Jojotheamazing/RcCar/README.md

# RcCar
Turning a simple hot wheel minicooper to functional. The plan is to get it to behave like a rc car controlled by my phone. This is my a testing project planning on going even smaller next time.
CAD files can be viewed on https://cad.onshape.com/documents/0ecd8efb05e9275814de94fb/w/fa9c31af8d81ab698a521477/e/6228325a7ca9a583648467fb its a public document onShape.
