Jojotheamazing/RcCar/Hot wheel-_rc car-bom.csv

Name | Purpose | Quantity | Total Cost (USD) | Link | Distributor
Esp32 mini c3 | Controlling with the phone | 1 | 2.40 | https://www.aliexpress.com/item/1005010312887045.html?curPageLogUid=ZZZyJdpMKHje | AliExpress
Motor driver | Control the motor | 1 | 1.60 | https://www.aliexpress.com/item/1005009044264044.html?mp=1 | AliExpress
