Jojotheamazing/RcCar/Assembly 2.step

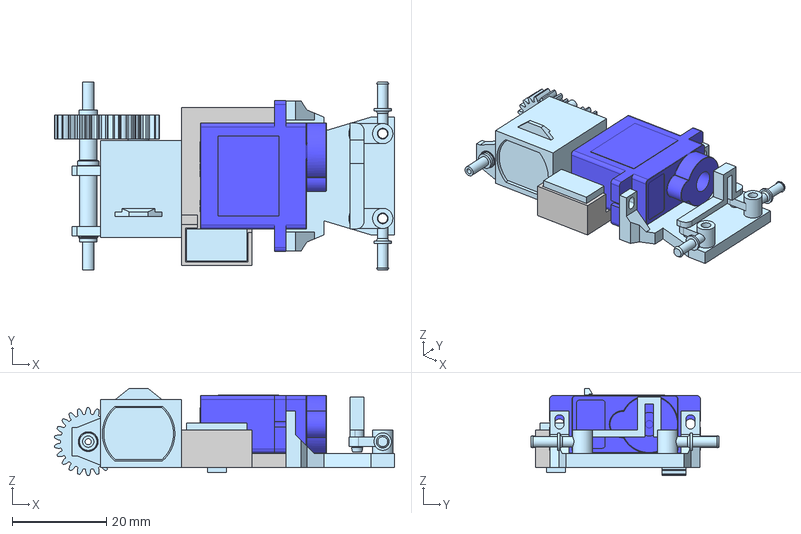
[picture p1: CAD file, 2026-03-25]
Assembly 2.step
72.2 x 40.0 x 18.5 mm
Spur gear (13 teeth)
Spur gear (22 teeth)
SG90 - Micro Servo 9g - Tower Pro.1_Pe�a
