Jojotheamazing/RcCar/JOURNAL.md

<!--
  This journal is auto generated by Stasis.
-->

# 4/3/2026 12 PM - The coding part.1

_Time spent: 1.333333333333333h_

Using websockets i made a code wich runs on the esp32 that creates a wifi network where phones and other devices can connect and controll the car. Its really nice since it doesnt require any app downloads and you dont need to carry a controller as well you just move it with and wifi capable device. i havent tested the range yet but in theory it should be decent. The website as i mentioned uses websokcets so it is real time which is needed it has basic ui that i proably change since i just wanted a test. It has a slider for throtle, steering and has settings for steeringOffset and max speed and also a beta feature for smooth accelaration and a save button which saves the values to the esp32 on board memory so you dont have to change it all the time(there is an issue that i havent worked on which when you load the website it doesnt show the setting but just the defaults however the settings are kept). 







# 4/2/2026 9 AM - Soldering & TPU tires

_Time spent: 2h_

Wanted to have a more complete version add be able to test it so i solder all the components together. After many attempts i finally figured it out since i had problems with the signal of the servo being inteferanced and making weird noise. I should add 2 capacitors as well but my soldering iron broke and i am currently wiating for them to replace it since its only 3 months old. I am facing some issues with the gear that i will work on (They sometimes get on a weird angle and jam it might be the way it is 3d printed). I also designed and 3d printed some simple tpu tires so it gets higher and a bit more grip which suprisingly got an amazing fit first try. Next time i will try fixing the gears by maybe adding a bearing or i will work on a demo code.



image0 (3)




# 3/25/2026 8 AM - DIY motor control

_Time spent: 0.25h_

Made a little motor driver with a transistor. Waiting for real motor driver since its not max efficiency.







# 3/25/2026 8 AM - Designing the car steering sytem motor hold and gears

_Time spent: 4h_

Using onShape i designed the 3d printed parts. Faced difficultes but overcame them. Starting idea was the servo gear to come in contact with a rack to turn left to right was not stable and the gears skipped changed to a more stable design. starting idea for the power was wheels directly to motor shaft problem; shaft was to short. Changed thinking added main wheel shaft which i was planning giving power with rubber bands but not good to much resistance. Realised the motor would fit in the casing by a little changed motor redesigned with gears. Added switch hold and charger. 
Στιγμιότυπο οθόνης 2026-03-25 102925

Στιγμιότυπο οθόνης 2026-03-25 102947
